RK3AZB-MIET/Student_board/Project Outputs for Student_Board/README.txt

Сопроводительный документ для проекта Student_brd_rev1.0
e-mail для связи german_antoshkin@mail.ru

Количество плат - 30
Количество слоев - 2
Материал - FR-4
Итоговая толщина платы - 2 mm +- 10%

Единицы измерения - миллиметры
Толщина меди во всех слоях - 18 um
Минимальный диаметр сквозного отверстия - 0.4 mm
Шелкография на верхем слое
Цвет маски -зелёный, шелкографии - белый
Необхоимо сделать скрайбирование

Порядок слоев:

PCB2.GTO - TOP шелкография
PCB2.GTS - TOP вскрытие маски
PCB2.GTL - TOP сигнальный слой

PCB2.GBL - BOTTOM сигнальный слой
PCB2.GBS - BOTTOM вскрытие маски

PCB2.GM2 - контур платы
PCB2.GM3 - линии скрайбирования

PCB2.TXT - файл сверловки
