RK3AZB-MIET/Student_board/Гайды/INV.png

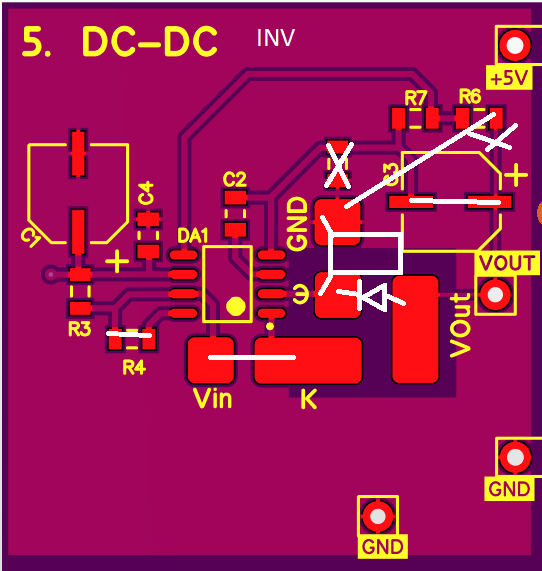
Гайды/INV.png
