RK3AZB-MIET/Student_board/Гайды/BOM_ПУС.xlsx

Узел | Тип | PN | Возможный аналог | Колич. в узле | Тех. запас | Общее кол-во | Стоимость, руб | Поставщик | Общая стоимость проекта:
ПУС_Мультивибратор | Транзистор | BC847 | КТ231А9 | 2 | 5 | 105 | 310.8 | СМП | 16102.38
ПУС_Мультивибратор | Светодиод | BL-LS0805UHR |  | 2 | 5 | 105 | 340.2 | Элитан
ПУС_Мультивибратор | Электролитический конденсатор | 105C RV2-16V101MSU-R ELNA | 100мкФ, 16VDC, 0605 | 2 | 5 | 105 | 1155 | СМП
ПУС_Мультивибратор | Резисторы 0805 5% | 300 Om |  | 2 | 5 | 105 | 78.75 | СМП
ПУС_Мультивибратор | Резисторы 0805 5% | 27k |  | 2 | 5 | 105 | 78.75 | СМП
ПУС_Мультивибратор | Резисторы 0805 5% | 6,8k |  | 2 | 5 | 105 | 78.75 | СМП
ПУС_Мультивибратор | Резисторы 0805 5% | 680Om |  | 2 | 5 | 105 | 78.75 | СМП
ПУС_Радиомикрофон | Транзистор | PMST2369,115 |  | 1 | 3 | 53 | 516.22 | Элитан
ПУС_Радиомикрофон | Транзистор | BC847 |  | 1 | 3 | 53 | 156.88 | СМП
ПУС_Радиомикрофон | Микрофон | EM6050P | подобрать более дешевые | 1 | 3 | 53
ПУС_Радиомикрофон | Конденсатор 0805 | 10пФ ±5% 50В 0805N100J50 |  | 3 | 8 | 158 | 260.7 | СМП
ПУС_Радиомикрофон | Конденсатор 0805 | 4,7pF |  | 1 | 3 | 100 | 203 | СМП
ПУС_Радиомикрофон | Конденсатор 0805 | 47pF |  | 1 | 3 | 100 | 165 | СМП
ПУС_Радиомикрофон | Конденсатор 0805 | 0,01мкФ±10% 100В 0805B103K101 |  | 3 | 8 | 158 | 474 | СМП
ПУС_Радиомикрофон | Резисторы 0805 5% | 100 Om |  | 1 | 3 | 100 | 75 | СМП
ПУС_Радиомикрофон | Резисторы 0805 5% | 4,7 kOm |  | 1 | 3 | 100 | 75 | СМП
ПУС_Радиомикрофон | Резисторы 0805 5% | 10 kOm |  | 1 | 3 | 100 | 75 | СМП
ПУС_Радиомикрофон | Резисторы 0805 5% | 22 kOm |  | 1 | 3 | 100 | 75 | СМП
ПУС_Радиомикрофон | Резисторы 0805 5% | 1 Mom |  | 1 | 3 | 100 | 75 | СМП
ПУС_Усилитель | Транзистор | BC847 |  | 1 | 3 | 53 | 156.88 | СМП
ПУС_Усилитель | Транзистор | BCX54-16 |  | 1 | 3 | 100 | 812 | Элитан
ПУС_Усилитель | Транзистор | BCX51-16 |  | 1 | 3 | 100 | 892 | Элитан
ПУС_Усилитель | Диод | PMLL4148L,115 | есть в рк - количество(?) | 2 | 5 | 105 | 201.6 | Элитан
ПУС_Усилитель | Танталовый конденсатор | 293D107X0016C2TE3 Vishay | 100мкФ, 16VDC, C-CASE | 1 | 3 | 53 | 1166 | СМП
ПУС_Усилитель | Танталовый конденсатор | TAJC106K035RNJ AVX | 10мкФ, 16VDC, C-CASE | 1 | 3 | 53 | 742 | СМП
ПУС_Усилитель | Электролитический конденсатор | 105C RV2-16V101MSU-R ELNA |  | 1 | 3 | 53 | 583 | СМП
ПУС_Усилитель | Конденсатор 0805 | 33n |  | 1 | 3 | 53
ПУС_Усилитель | Резисторы 0805 5% | 510 Om |  | 1 | 3 | 53 | 75 | СМП
ПУС_Усилитель | Резисторы 0805 5% | 1k |  | 2 | 5 | 105 | 150 | СМП
ПУС_Усилитель | Резисторы 0805 5% | 100k |  | 1 | 3 | 53 | 75 | СМП
ПУС_Усилитель | Разъем | СКХ3-3.5-26 |  | 1 | 3 | 100 | 726 | Элитан
ПУС_DC-DC | Электролитический конденсатор | 105C RV2-16V101MSU-R ELNA | 100мкФ, 16VDC, 0605 | 2 | 5 | 105 | 1155 | СМП
ПУС_DC-DC | Резисторы 0805 5% | 1 Om |  | 1 | 3 | 53 | 75 | СМП
ПУС_DC-DC | Резисторы 0805 5% | 180 Om |  | 1 | 3 | 53 | 75 | СМП
ПУС_DC-DC | Резисторы 0805 5% | 10k |  | 2 | 5 | 105 | 75 | СМП
ПУС_DC-DC | Конденсатор 0805 | 680pF |  | 1 | 3 | 100 | 300 | СМП
ПУС_ОУ | Микросхема | LM358DR |  | 1 | 3 | 100 | 1500 | Элитан
ПУС_Защита_USB | Предохранитель | SMD1812P050TF | Самовосстанавливающиеся предохранители SMD 1812 | 1 | 3 | 53 | 1560 | СМП
ПУС_Защита_USB | Резисторы 0805 5% | 1k |  | 2 | 5 | 105 | 75 | СМП
ПУС_Защита_USB | SMF7.0A |  |  | 1 | 3 | 53 | 159 | Чип и Дип
ПУС_Защита_USB | Светодиод | BL-LS0805UHR |  | 1 | 2.5 | 52.5 | 170.1 | Элитан
Прочее | PLS-2 (DS1021-1x2) |  |  | 20 |  | 1000 | 620 | Элитан
LoRa_пейджер | Зуммер пассивный 12мм | KPM-G1203B1, KEPO |  | 1 |  |  | 30 | Чип и Дип
LoRa_пейджер | Катушка индуктивности SMD | B82498F3390J000 | LQW2BHN39NJ03 | 1 |  |  | 42 | СМП
LoRa_пейджер | Танталовый конденсатор B-case | 293D106X0016B2TE3 Vishay |  | 3 | 2 |  | 85 | СМП
LoRa_пейджер | Flash-память | W25Q80DVSNIG TR |  | 3 | 2 | 10 | 330 | Элитан
