RK3AZB-MIET/Student_board/PCB/STEP/User Library-capacitor size D.STEP

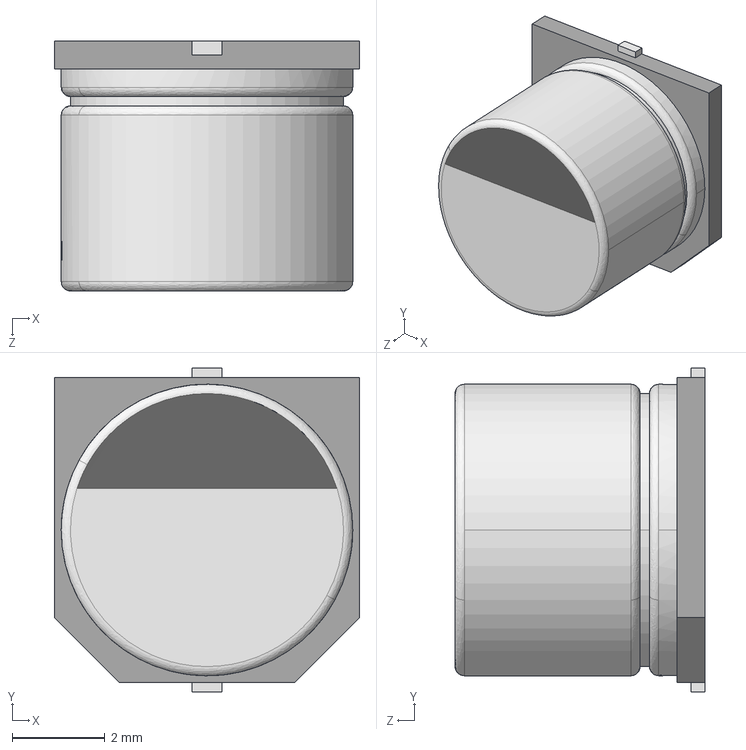
[picture p15: CAD file, 2022-09-17]
PCB/STEP/User Library-capacitor size D.STEP
6.60 x 7.00 x 5.41 mm
