RK3AZB-MIET/Student_board/PCB/STEP/User Library-Jumper.STEP

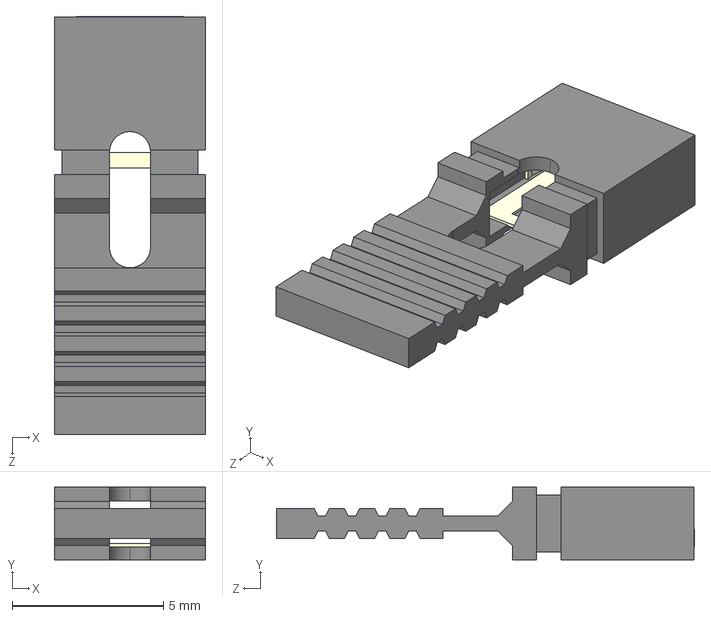
[picture p16: CAD file, 2022-09-17]
PCB/STEP/User Library-Jumper.STEP
5.00 x 2.40 x 13.8 mm
