RK3AZB-MIET/Student_board/PCB/STEP/КТ4-35.STEP

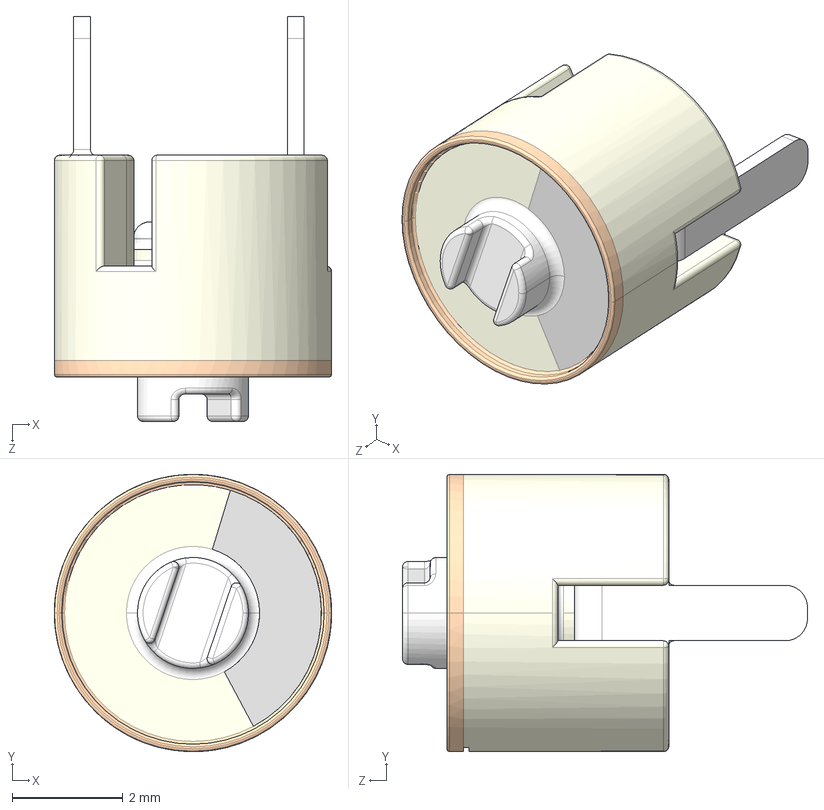
[picture p17: CAD file, 2022-09-13]
PCB/STEP/КТ4-35.STEP
5.00 x 5.00 x 7.30 mm
