RK3AZB-MIET/Student_board/PCB/STEP/User Library-PJ-320B.STEP

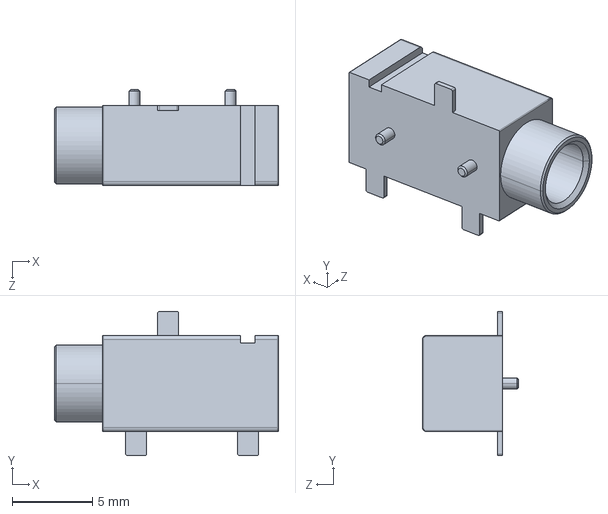
[picture p18: CAD file, 2022-09-13]
PCB/STEP/User Library-PJ-320B.STEP
14.0 x 9.00 x 6.00 mm
