RK3AZB-MIET/Student_board/PCB/STEP/User Library-SOT323 (SC70-3)-1.STEP

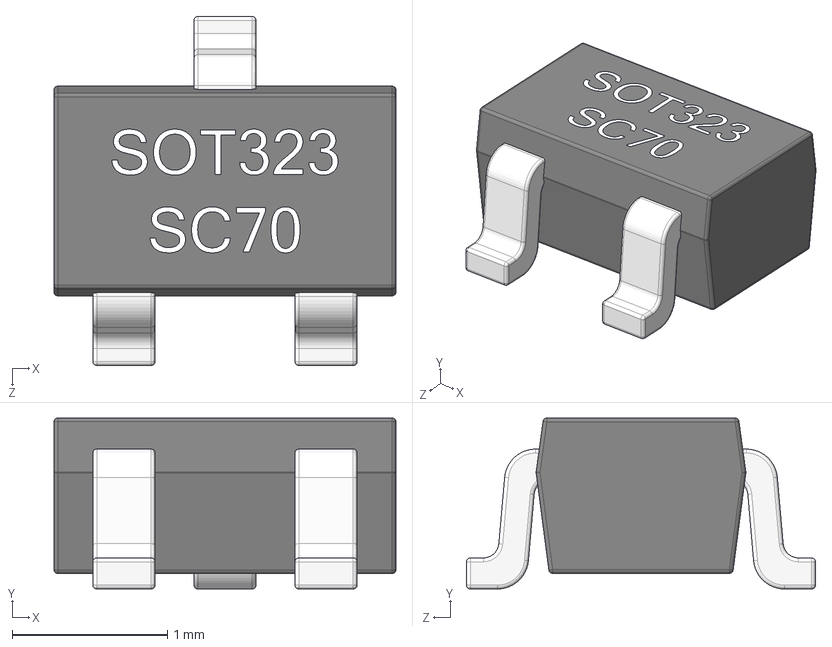
[picture p19: CAD file, 2022-09-13]
PCB/STEP/User Library-SOT323 (SC70-3)-1.STEP
2.20 x 1.10 x 2.25 mm
K_X_F6rper_1
Beschriftung_1
Pins_1 x 3
