RK3AZB-MIET/Student_board/PCB/STEP/pj-314a3.step

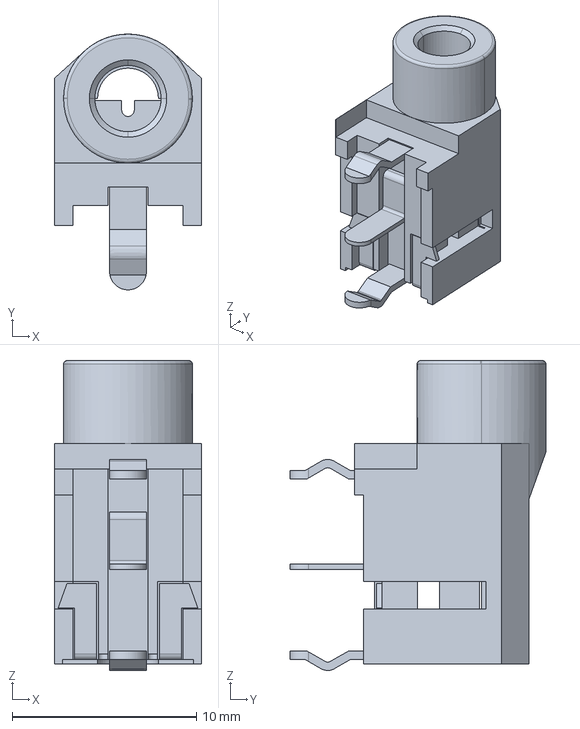
[picture p20: CAD file, 2022-09-09]
PCB/STEP/pj-314a3.step
8.00 x 13.9 x 16.8 mm
