RK3AZB-MIET/Student_board/PCB/STEP/sdr0604-221kl.stp

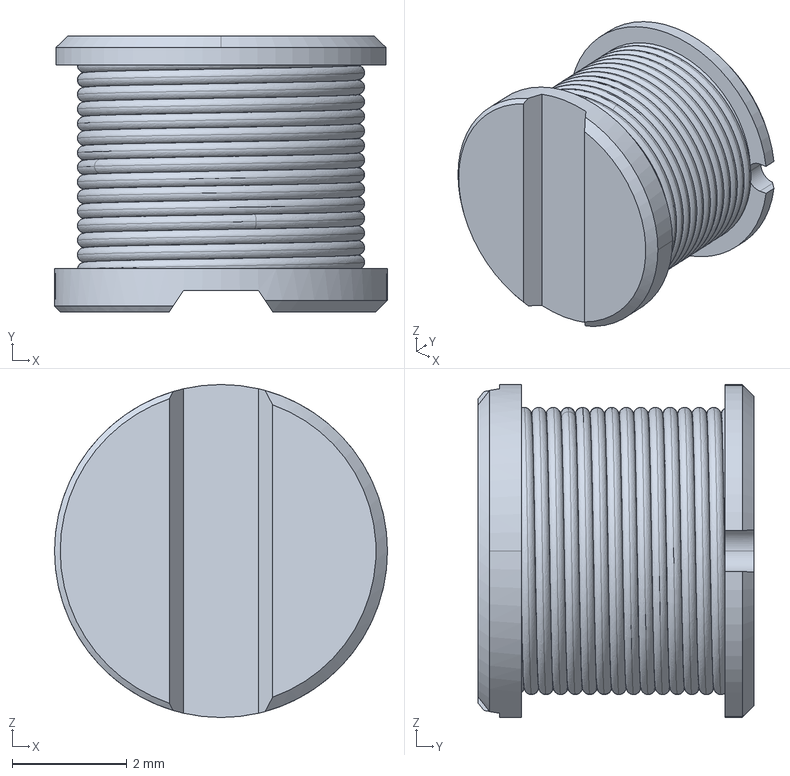
[picture p21: CAD file, 2022-09-04]
PCB/STEP/sdr0604-221kl.stp
5.80 x 4.80 x 5.80 mm
