RK3AZB-MIET/Student_board/PCB/STEP/User Library-PLS-1.STEP

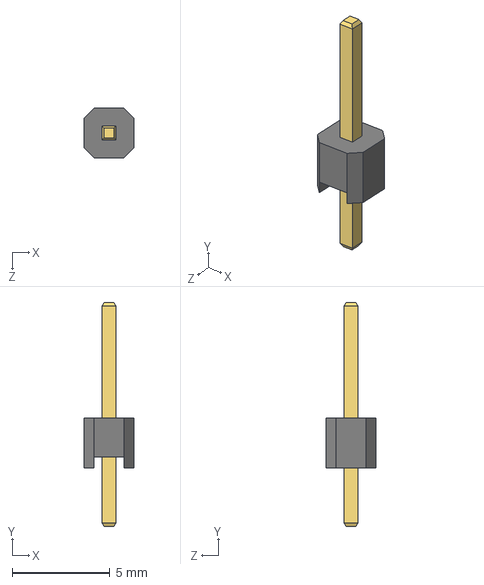
[picture p22: CAD file, 2022-09-04]
PCB/STEP/User Library-PLS-1.STEP
2.54 x 11.4 x 2.54 mm
