RK3AZB-MIET/Student_board/Гайды/ПУС.PDF

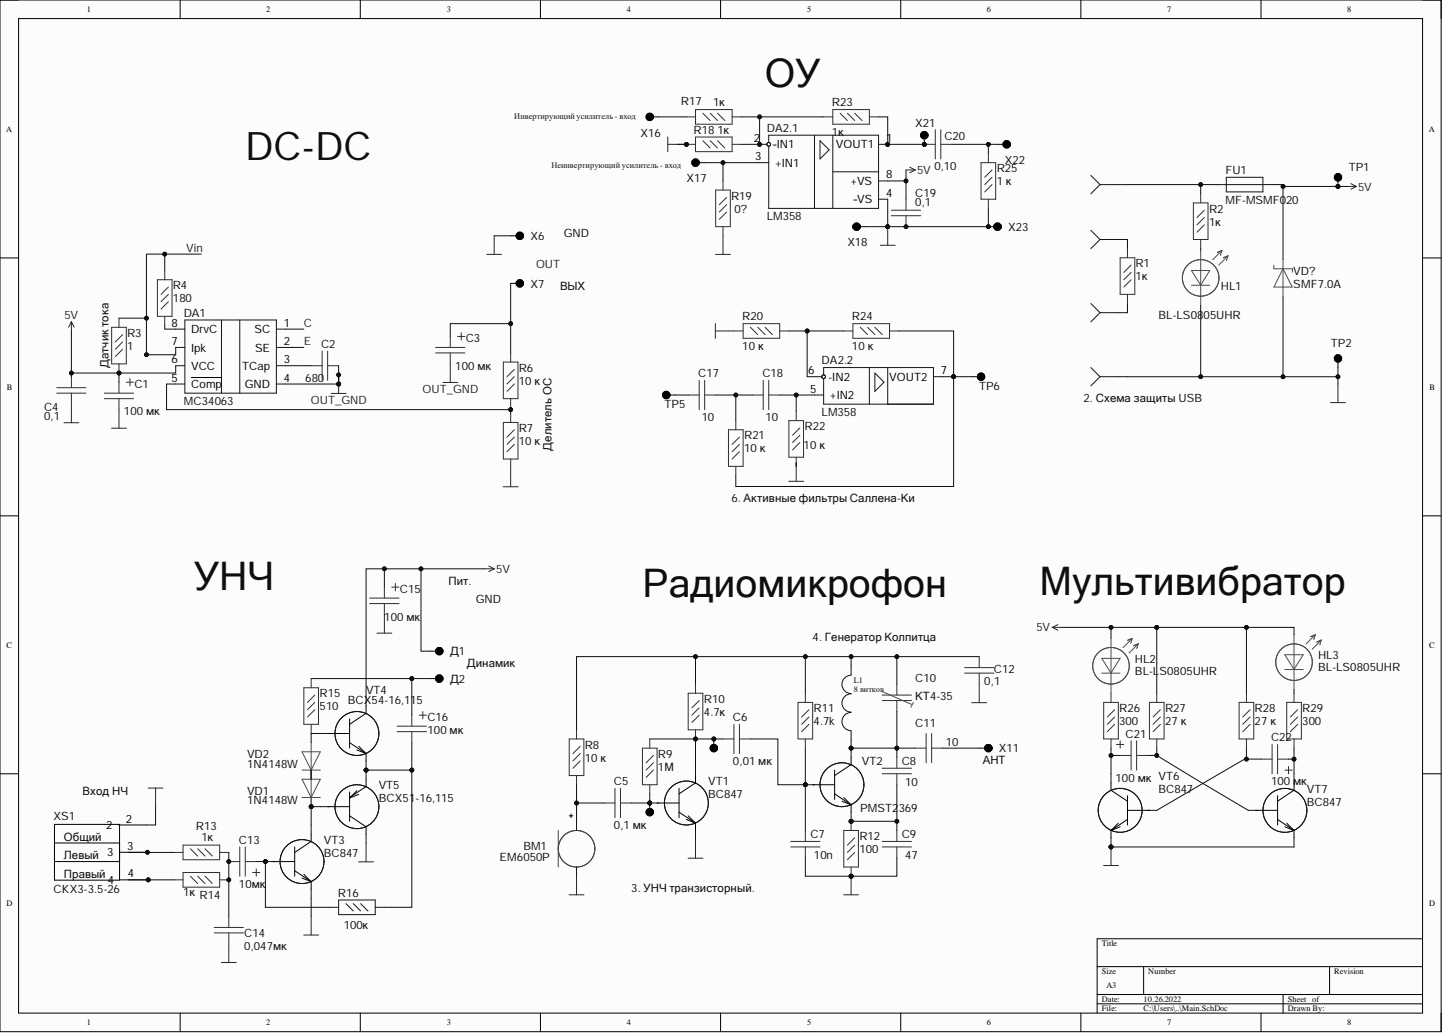
[picture p23: page 1]
