RK3AZB-MIET/Student_board/Гайды/сборочный чертеж.pdf

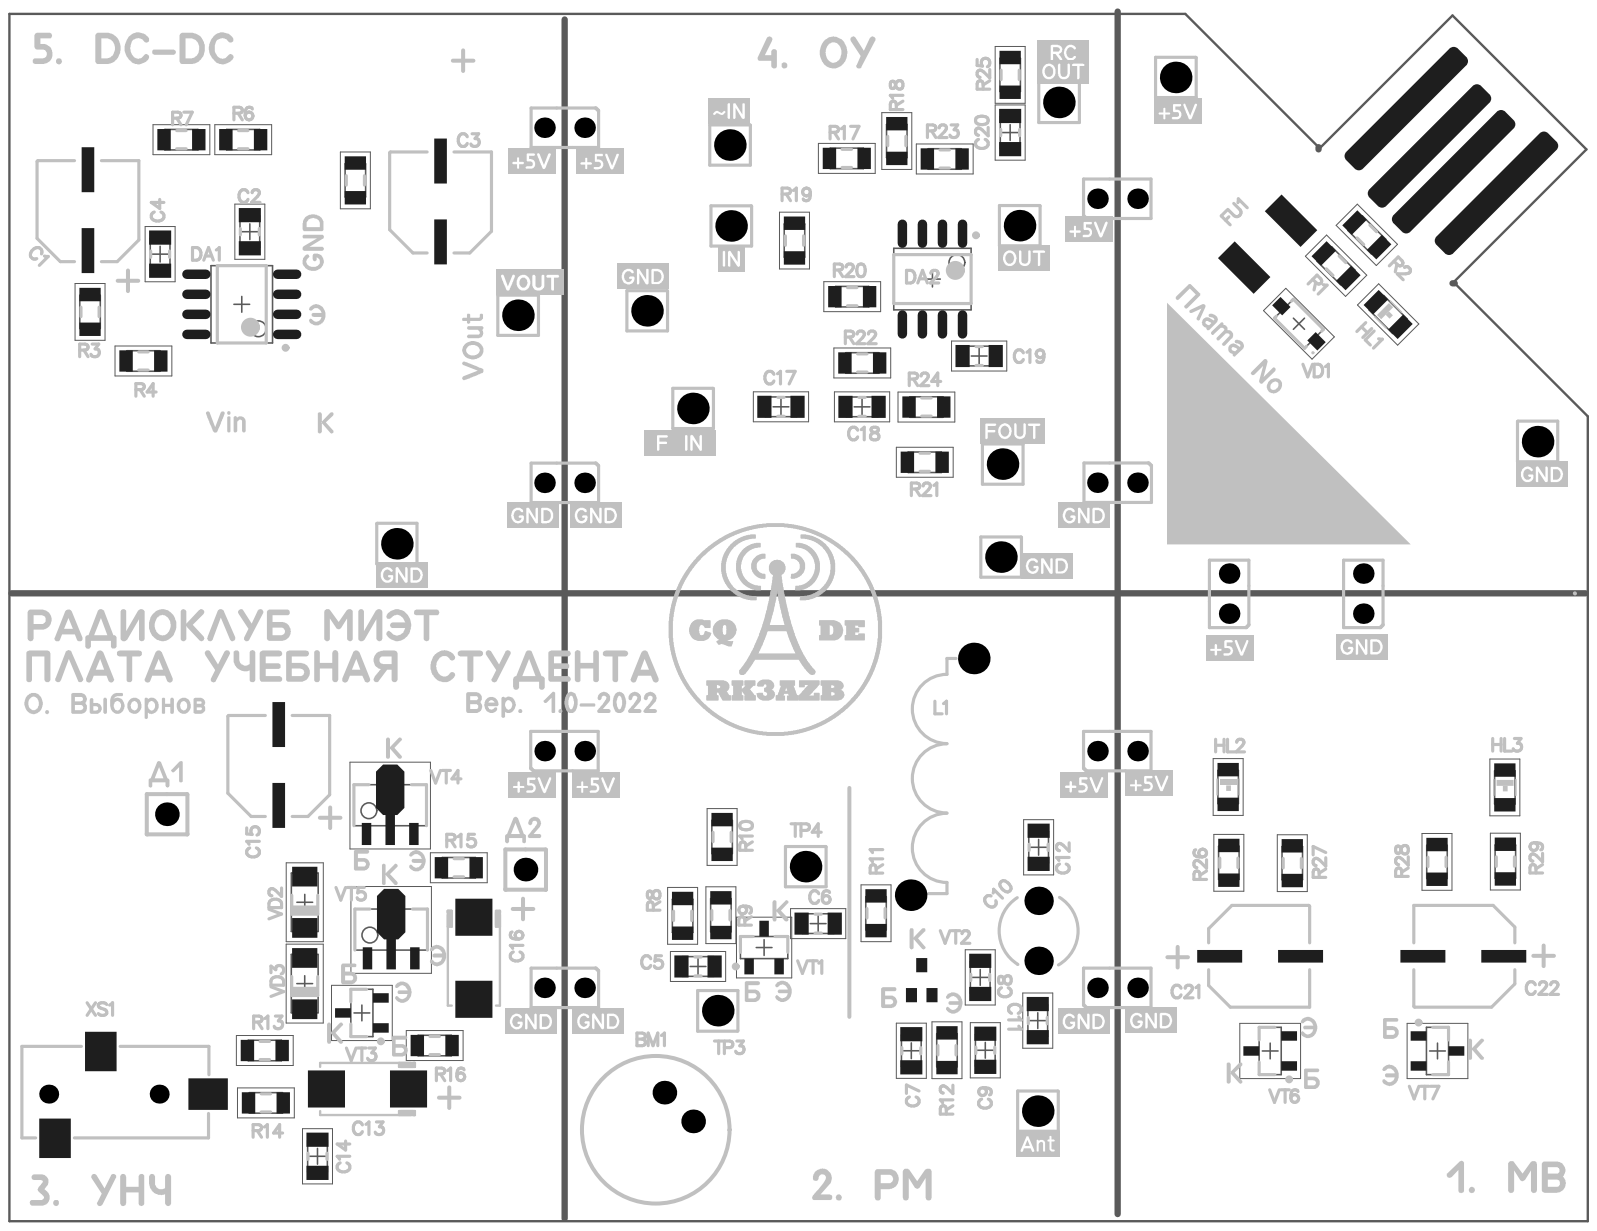
[picture p24: page 1]

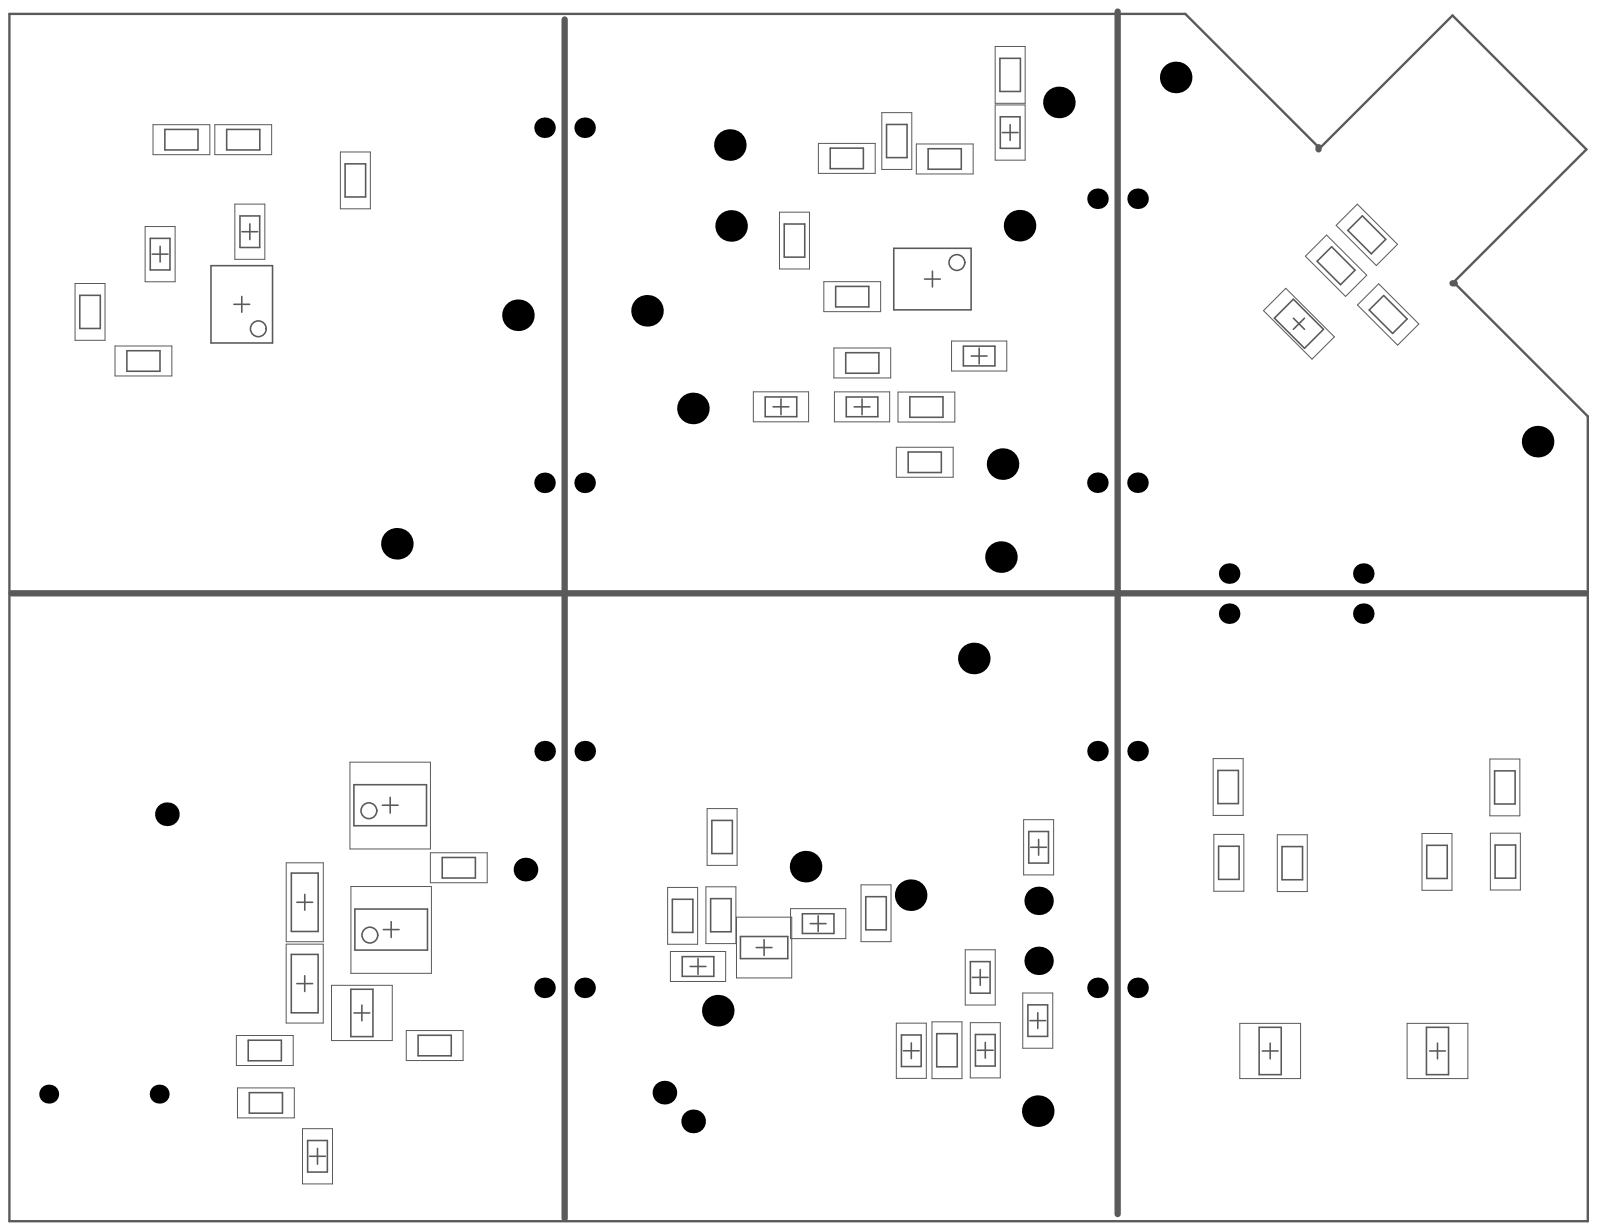
[picture p25: page 2]
