RK3AZB-MIET/Student_board/(list of files, drawings)

Other design files:
PCB/Amplifier.SchDoc
PCB/DC-DC.SchDoc
PCB/Main.SchDoc
PCB/Multivibrator.SchDoc
PCB/Operational_amplifier.SchDoc
PCB/PCB2.PcbDoc
PCB/PCB2.PcbLib
PCB/Radio_bug.SchDoc
PCB/STEP/User_Library.PcbLib
PCB/Student_Board.PrjPcb
PCB/Student_Board.SCHLIB
PCB/USB_Protection.SchDoc
PCB/User_Library.SchLib
Student_Board.PrjPcb
