RK3AZB-MIET/Student_board/Гайды/STEP_DWN.png

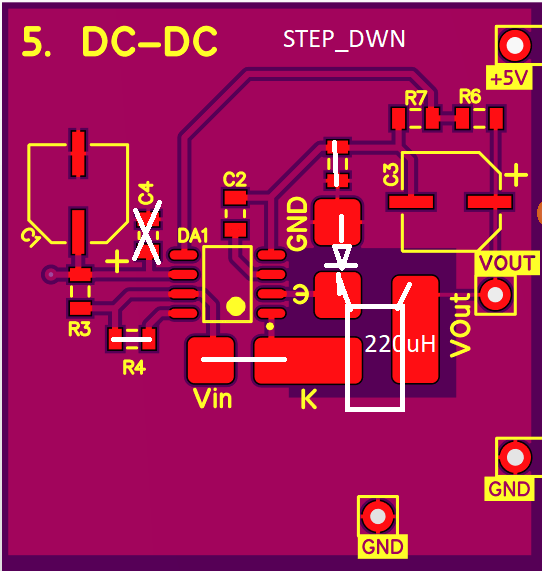
Гайды/STEP_DWN.png
