RK3AZB-MIET/Student_board/Гайды/STEP_UP.png

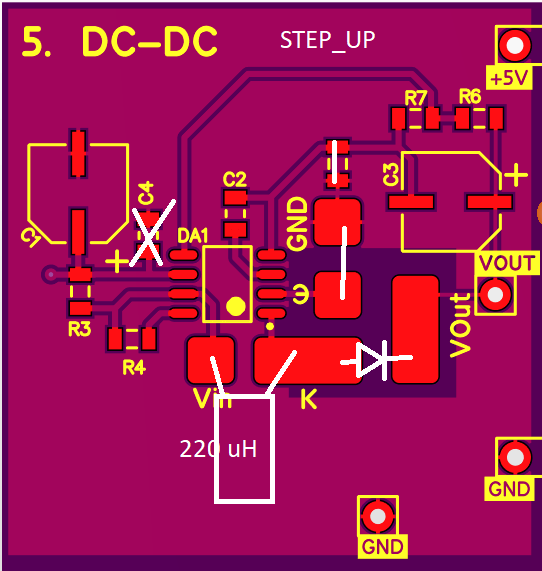
Гайды/STEP_UP.png
