RK3AZB-MIET/Student_board/(commit log)

2022-09-04 Версия 1.0
    [Amplifier.SchDoc, DC-DC.SchDoc, Multivibrator.SchDoc, Operational_amplifier.SchDoc, PCB2.PcbLib, Radio_bug.SchDoc, Sheet1.SchDoc, Sheet2.SchDoc]
2022-09-17 Pre-final version
    [Amplifier.SchDoc, DC-DC.SchDoc, Multivibrator.SchDoc, Operational_amplifier.SchDoc, PCB2.PcbLib, Radio_bug.SchDoc, Student_Board.PrjPcb, USB_Protection.SchDoc]
2022-09-18 Final version
    [DC-DC.SchDoc, PCB2.PcbDoc, User_Library.PcbLib]
